AndySmithers/WeatherStation/PCB Assembly/PCB_Assembly.jpg

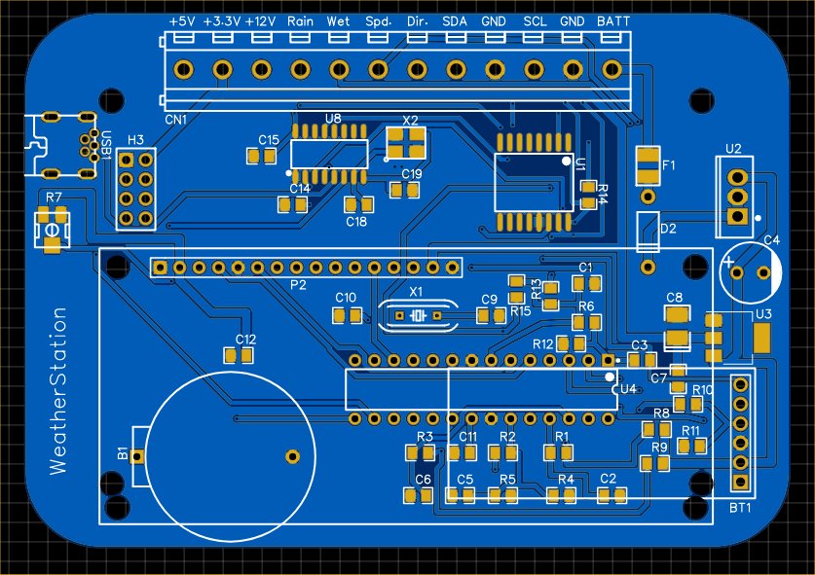
PCB Assembly/PCB_Assembly.jpg
