AndySmithers/WeatherStation/README.md

# WeatherStation
Arduino &amp; Raspberry Pi Weather Station
