AndySmithers/WeatherStation/Schematic/Schematic_WeatherStation_2021-10-19.pdf

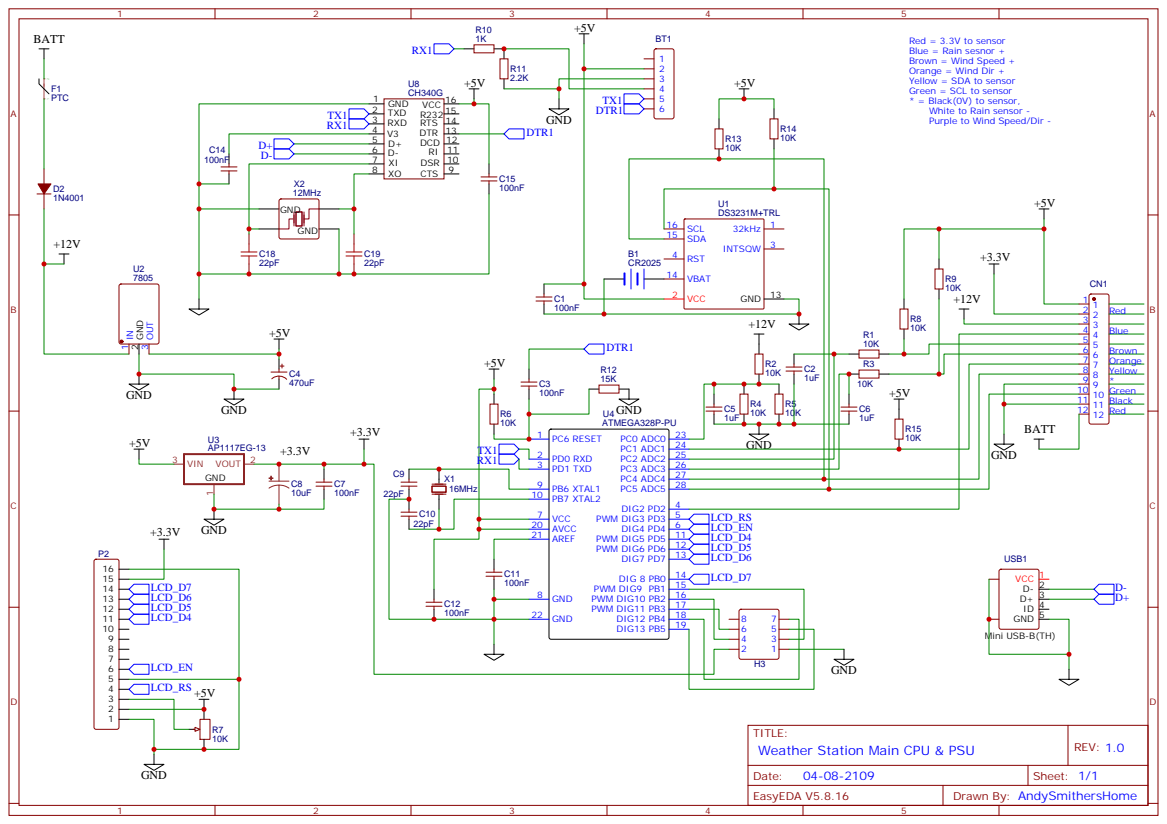
[picture p2: page 1]

Red = 3.3V to sensor
Blue = Rain sesnor +
Brown = Wind Speed +
Orange = Wind Dir +
Yellow = SDA to sensor
Green = SCL to sensor
* = Black(0V) to sensor,
White to Rain sensor -
Purple to Wind Speed/Dir -
