AndySmithers/WeatherStation/(list of files, drawings)

Other design files:
EasyEDA/PCB_1-PCB_PCB_2020-12-28_18-16-33_2021-10-19.json
