AndySmithers/WeatherStation/(commit log)

2021-10-19 EasyEDA Files
    [PCB_1-PCB_PCB_2020-12-28_18-16-33_2021-10-19.json]
2021-10-19 PCB Assembly
